floesche/LED-Display_G3_Hardware_Controller/README.md

---
title: Controller PCB
parent: Generation 3
---

# panels_controller_design  

CAD design files, gerber files and parts list for the Panels Controller.
