floesche/LED-Display_G3_Hardware_Controller/docs/assets/panel_controller_rev_c_schematic.pdf

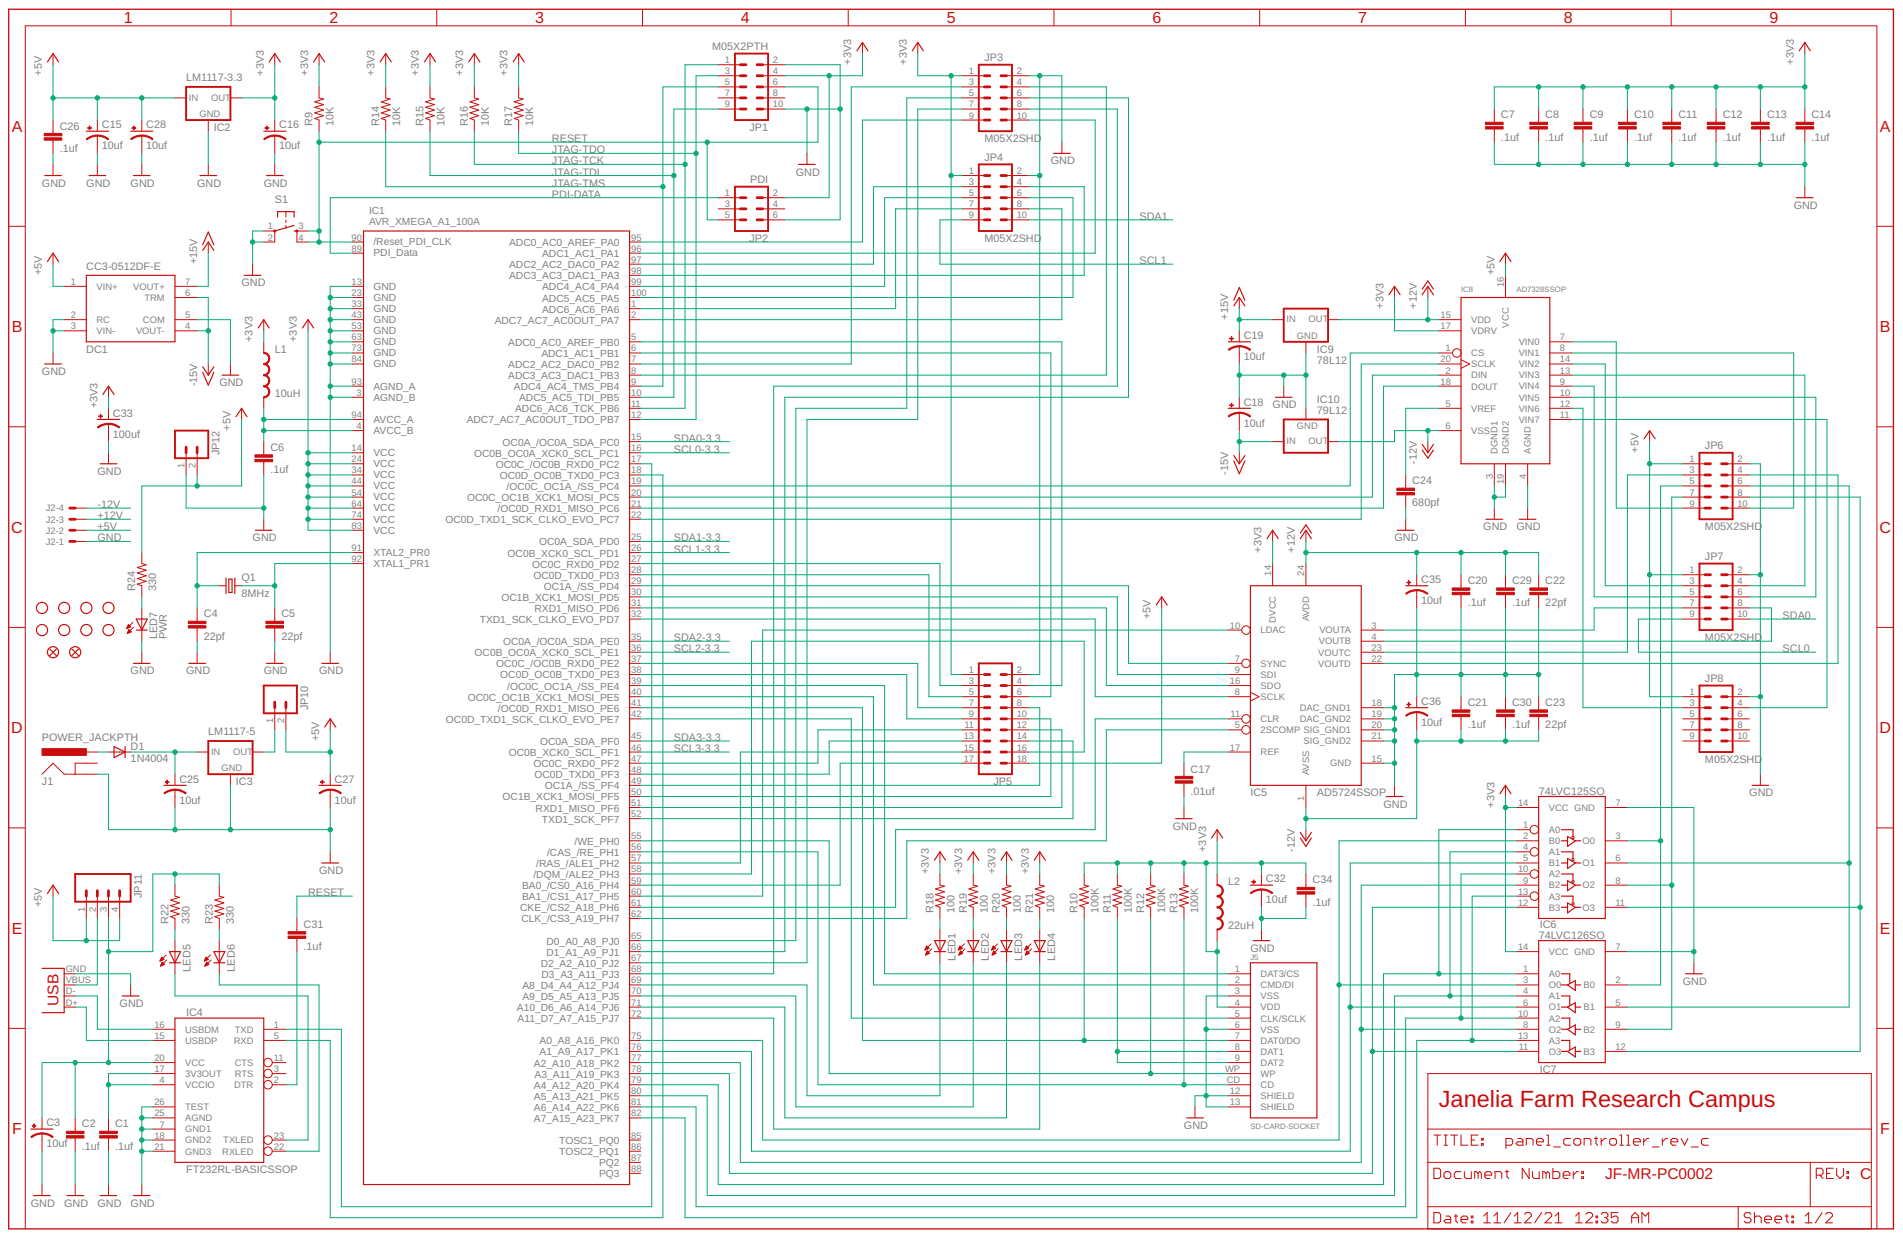
[picture p3: page 1]

RESET
JTAG-TDO
JTAG-TCK
JTAG-TDI PDI-DATA
JTAG-TMS

GND

48
49
50

Janelia Farm Research Campus

GND GND

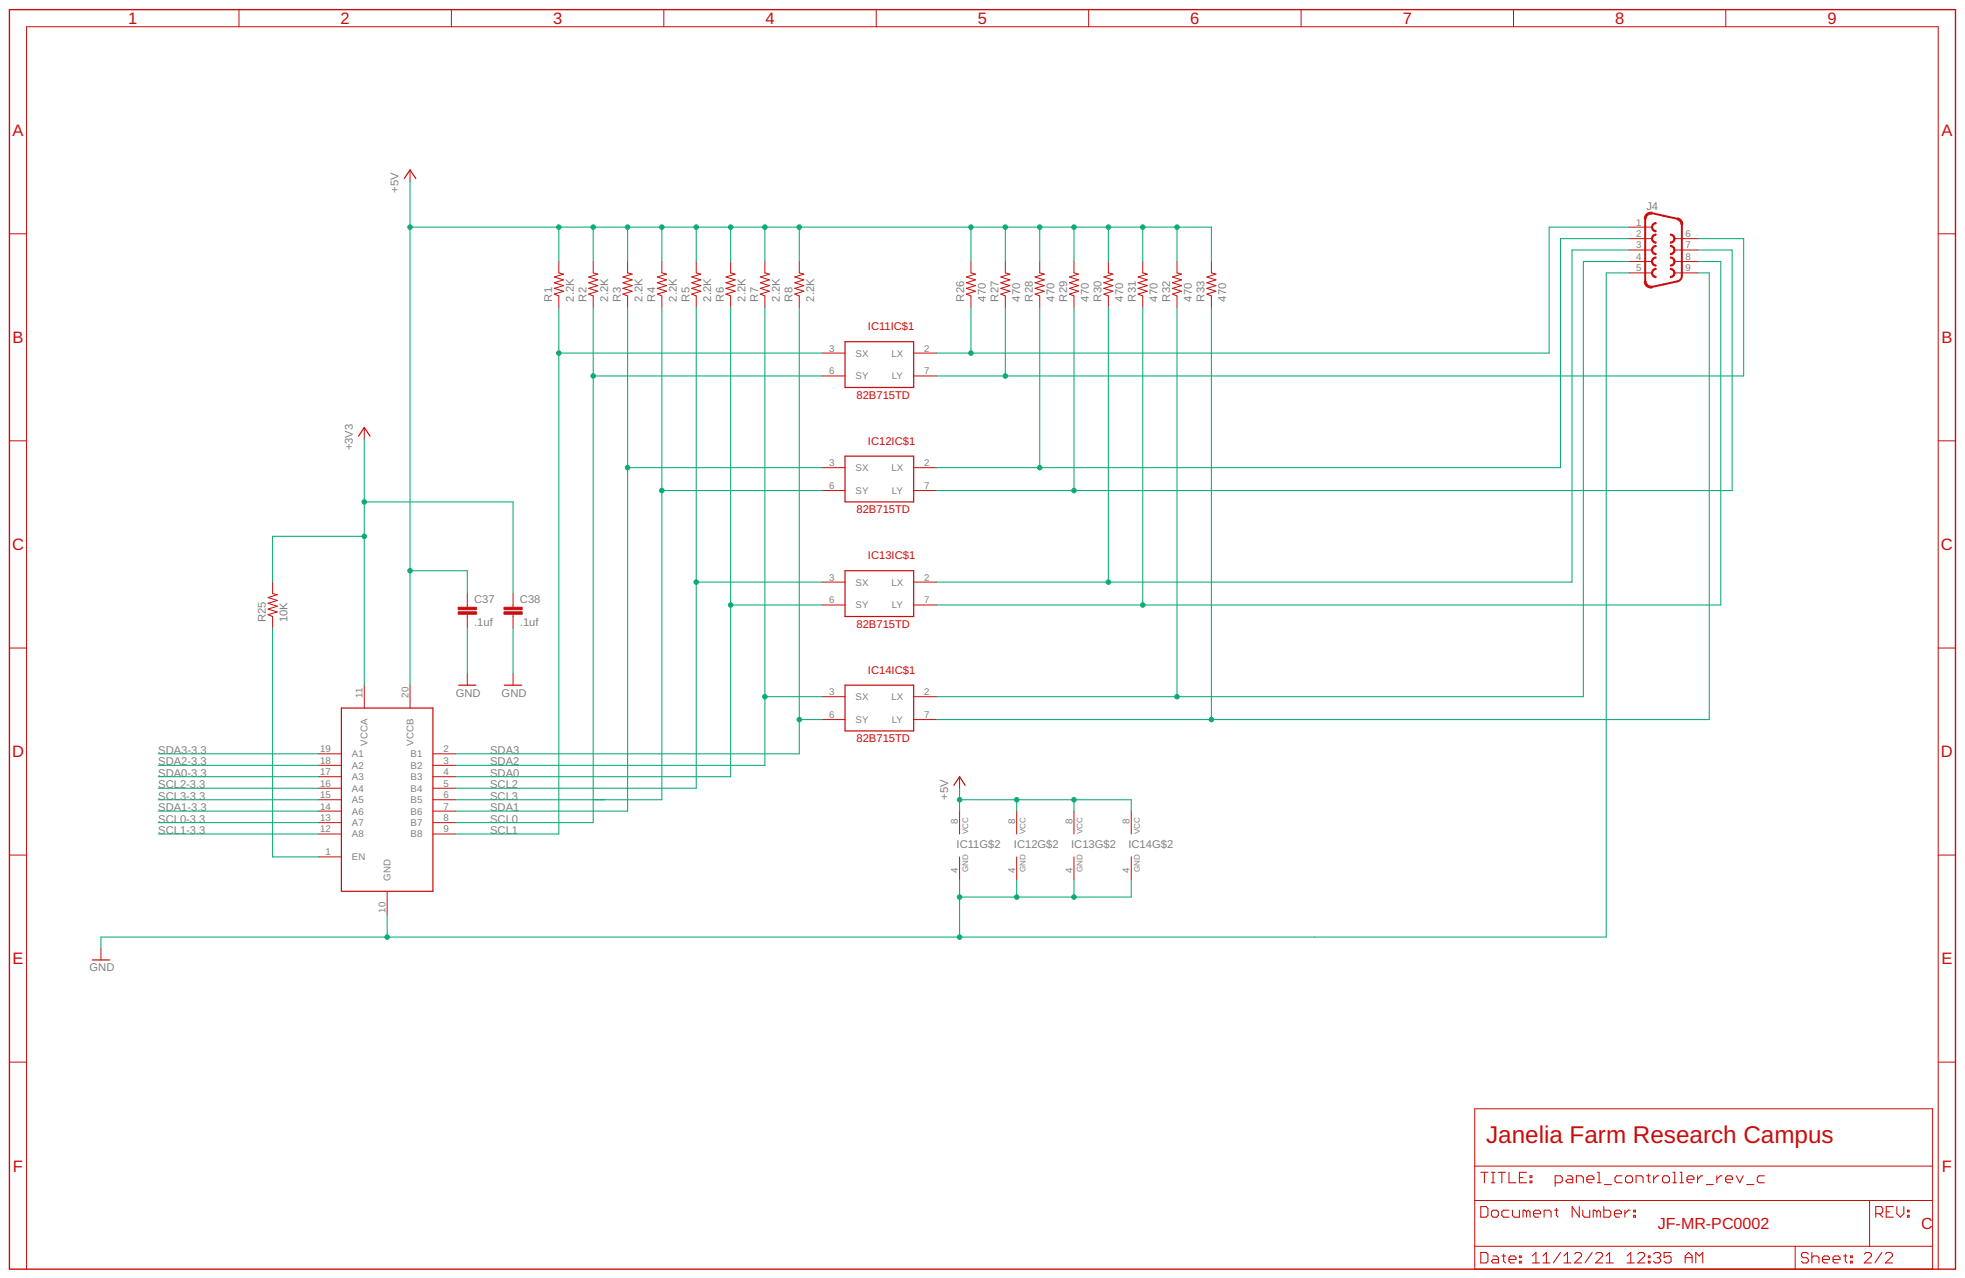
[picture p4: page 2]

3 B3
4 B4
5 B5
6 B6
7 B7

Janelia Farm Research Campus
