floesche/LED-Display_G3_Hardware_Controller/panel_controller_rev_c.brd

## EAGLE design panel_controller_rev_c.brd (2021-11-12)

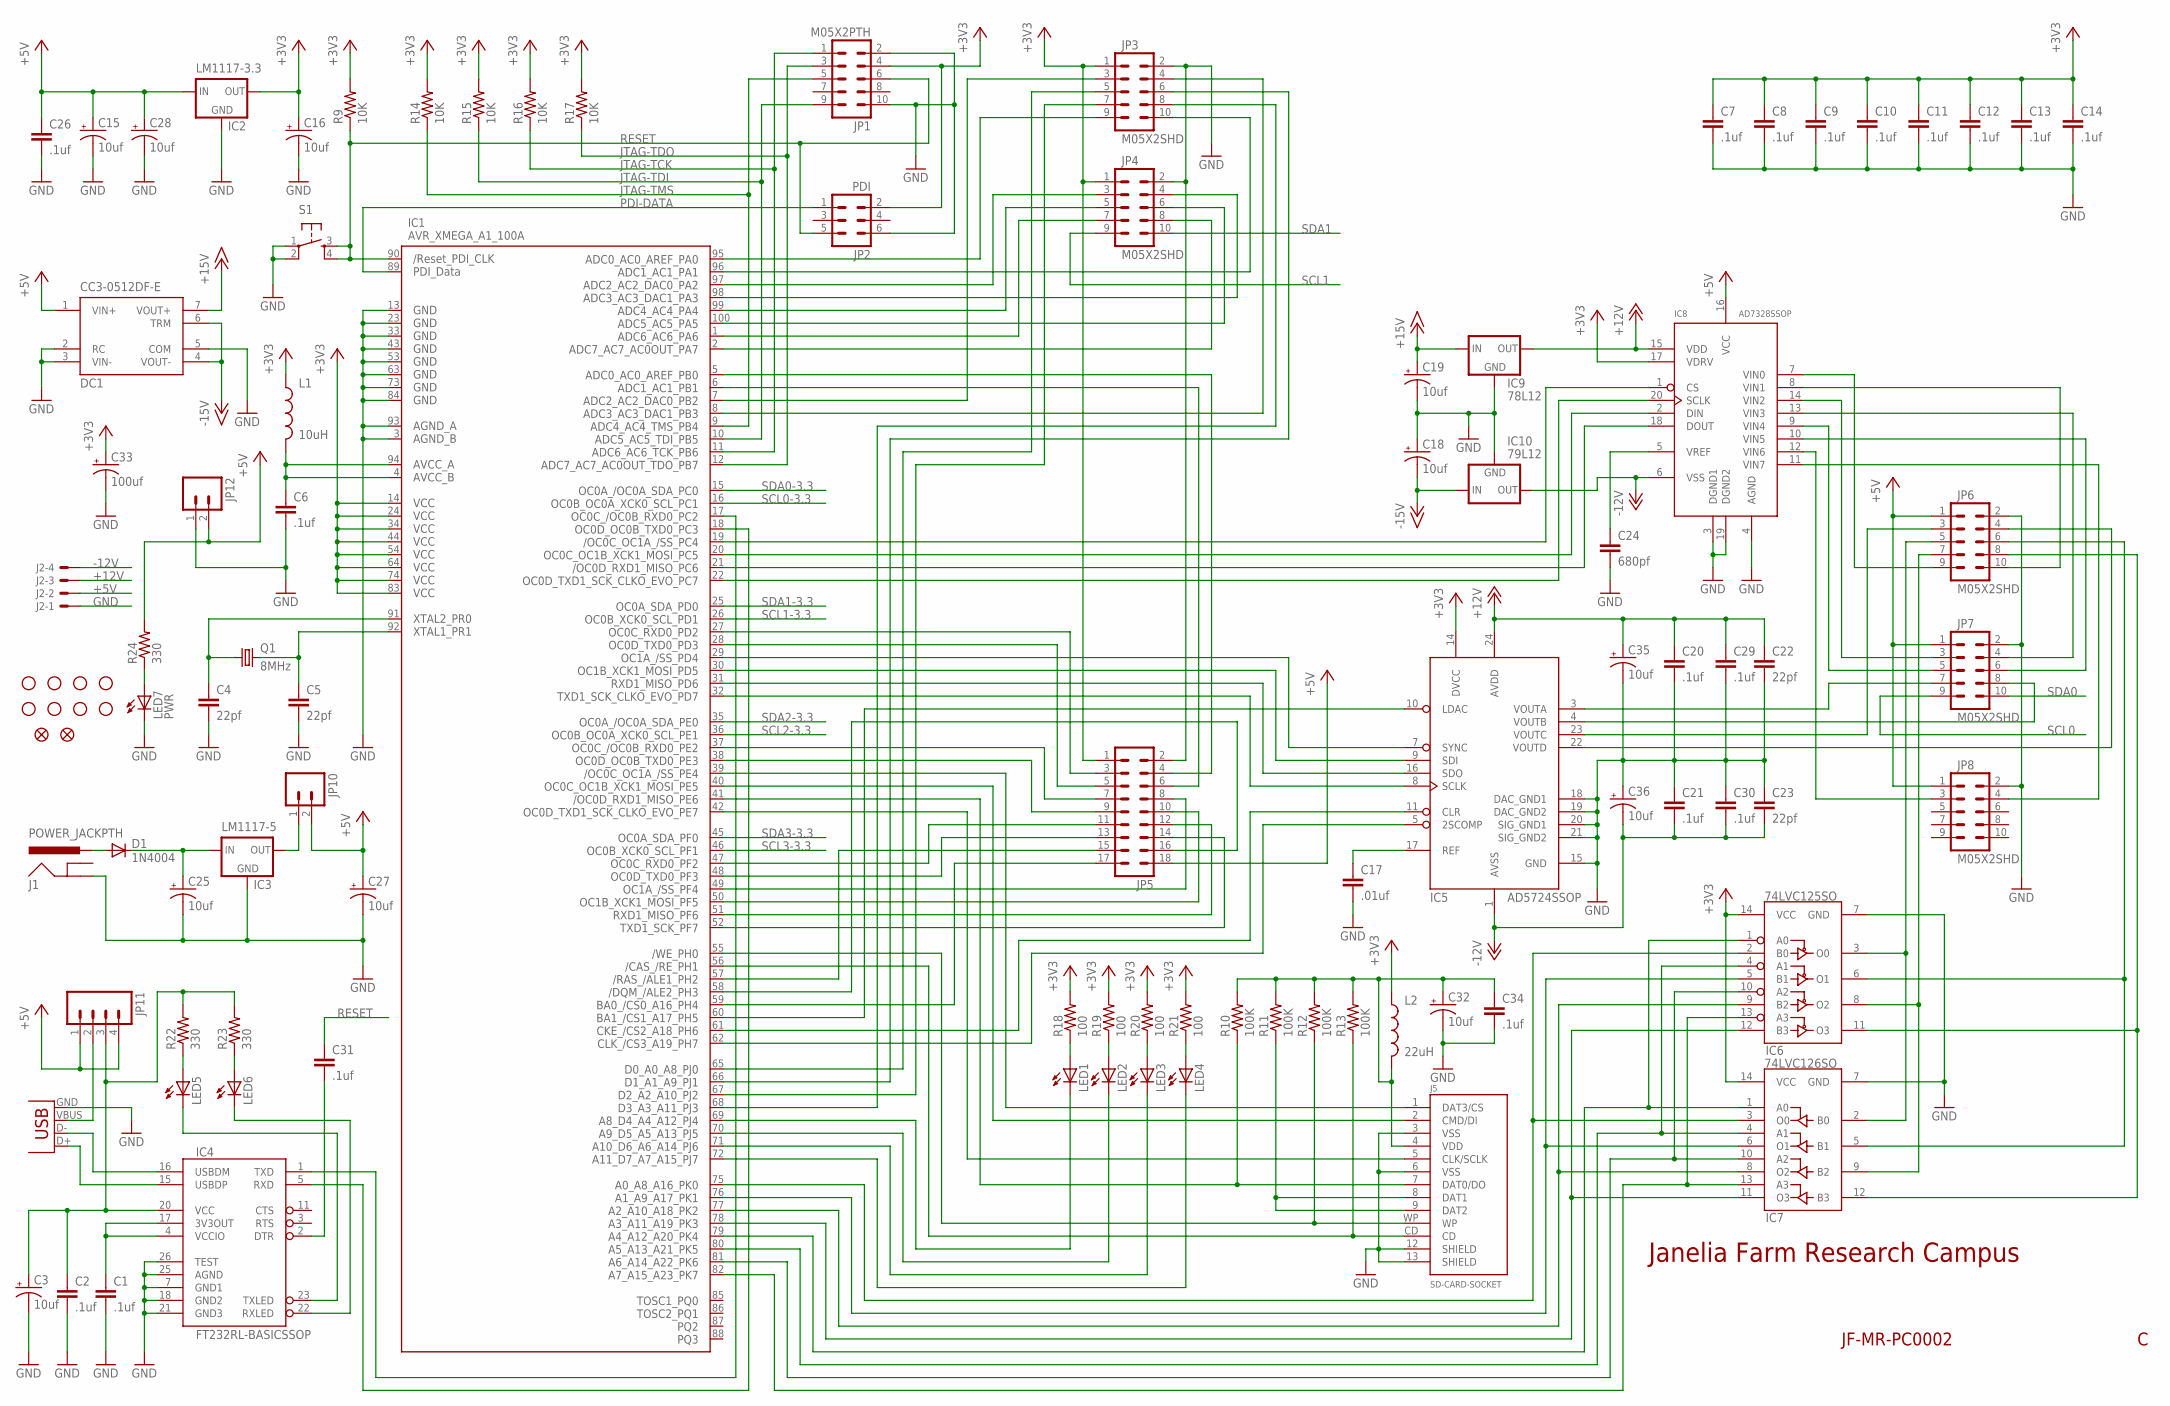
[picture p5: schematic panel_controller_rev_c.sch, sheet 1]

Parts:
C1, C2, C6, C7, C8, C9, C10, C11, C12, C13, C14, C20, C21, C26, C29, C30, C31, C34: .1uf; 0603
C3, C15, C16, C18, C19, C25, C27, C28, C32, C35, C36: 10uf; EIA3216
C4, C5, C22, C23: 22pf; 0603
C17: .01uf; 0603
C24: 680pf; 0603
C33: 100uf; PANASONIC_E
D1: 1N4004; DO41-10
DC1: CC3-0512DF-E; CC3-TH
IC1: AVR_XMEGA_A1_100A; TQFP100
IC2: LM1117-3.3; SOT223
IC3: LM1117-5; SOT223
IC4: FT232RL-BASICSSOP; SSOP28DB
IC5: AD5724SSOP; TSSOP24
IC6: 74LVC125SO; SO014
IC7: 74LVC126SO; SO014
IC8: AD7328SSOP; TSSOP20
IC9: 78L12; SOT89
IC10: 79L12; SOT89
J1: POWER_JACKPTH; POWER_JACK_PTH
J2: KK-156-4
J3: USBPTH; USB-B-PTH
J5: SD-CARD-SOCKET; SD-MMC_SOCKET-3M
JP1: M05X2PTH; MA05-2
JP2: PDI; MA03-2
JP3, JP4, JP6, JP7, JP8: M05X2SHD; 2X5-SHROUDED
JP5: MA09-2
JP10, JP12: M02PTH; 1X02
JP11: M04PTH; 1X04
L1: 10uH; 0805
L2: 22uH; 0805
LED1, LED2, LED3, LED4, LED5, LED6: LED3MM
LED7: PWR; LED3MM
Q1: 8MHz; HC49UP
R9, R14, R15, R16, R17: 10K; 0603
R10, R11, R12, R13: 100K; 0603
R18, R19, R20, R21: 100; 0603
R22, R23, R24: 330; 0603
S1: TAC_SWITCHB3S-1000; OMRON
U$1, U$2: FIDUCIAL1X2; FIDUCIAL-1X2
U$3, U$4, U$5, U$6, U$7, U$8, U$9, U$10: STAND-OFF

Connections:
+3V3: C7.1, C8.1, C9.1, C10.1, C11.1, C12.1, C13.1, C14.1, C16.A (+), C33.+, IC1.14 (VCC1), IC1.24 (VCC2), IC1.34 (VCC3), IC1.44 (VCC4), IC1.54 (VCC5), IC1.64 (VCC6), IC1.74 (VCC7), IC1.83 (VCC8), IC2.2 (OUT), IC5.14 (DVCC), IC6.14 (VCC), IC7.14 (VCC), IC8.17 (VDRV), JP1.4, JP2.2, JP3.1, JP4.1, JP5.1, L1.1, L2.1, R9.2, R14.2, R15.2, R16.2, R17.2, R18.2, R19.2, R20.2, R21.2; also elsewhere on the board
+5V: C15.A (+), C26.1, C27.A (+), C28.A (+), DC1.1 (VIN+), IC2.3 (IN), IC8.16 (VCC), J2.2, JP5.18, JP6.1, JP7.1, JP8.1, JP10.2, JP11.1, JP11.4, JP12.2, R24.2; also elsewhere on the board
+12V: C20.1, C22.1, C29.1, C35.A (+), IC5.24 (AVDD), IC8.15 (VDD), IC9.1 (OUT), J2.3
+15V: C19.A (+), DC1.7 (VOUT+), IC9.3 (IN)
-12V: C21.2, C23.2, C30.2, C36.C (-), IC5.1 (AVSS), IC8.6 (VSS), IC10.3 (OUT), J2.4
-15V: C18.C (-), DC1.4 (VOUT-), DC1.6 (TRM), IC10.2 (IN)
GND: C1.2, C2.2, C3.C (-), C4.2, C5.2, C6.2, C7.2, C8.2, C9.2, C10.2, C11.2, C12.2, C13.2, C14.2, C15.C (-), C16.C (-), C17.2, C18.A (+), C19.C (-), C20.2, C21.1, C22.2, C23.1, C24.2, C25.C (-), C26.2, C27.C (-), C28.C (-), C29.2, C30.1, C32.C (-), C33.-, C34.2, C35.C (-), C36.A (+), DC1.2 (RC), DC1.3 (VIN-), DC1.5 (COM), IC1.3 (AGND_B), IC1.13 (GND1), IC1.23 (GND2), IC1.33 (GND3), IC1.43 (GND4), IC1.53 (GND5), IC1.63 (GND6), IC1.73 (GND7), IC1.84 (GND8), IC1.93 (AGND_A), IC2.1 (GND), IC3.1 (GND), IC4.7 (GND1), IC4.18 (GND2), IC4.21 (GND3), IC4.25 (AGND), IC4.26 (TEST), IC5.15 (GND), IC5.18 (DAC_GND1), IC5.19 (DAC_GND2), IC5.20 (SIG_GND1), IC5.21 (SIG_GND2), IC6.7 (GND), IC7.7 (GND), IC8.3 (DGND1), IC8.4 (AGND), IC8.19 (DGND2), IC9.2 (GND), IC10.1 (GND), J1.GND, J2.1, J3.GND, J5.3 (VSS), J5.6 (VSS), J5.12 (SHIELD), J5.13 (SHIELD), JP1.2, JP1.10, JP2.6, JP3.2, JP4.2, JP5.2, JP6.2, JP7.2, JP8.2, JP12.1, LED7.K (C), S1.1, S1.2; also elsewhere on the board
JTAG-TCK: IC1.11 (PB6), JP1.1, R16.1
JTAG-TDI: IC1.10 (PB5), JP1.9, R15.1
JTAG-TDO: IC1.12 (PB7), JP1.3, R17.1
JTAG-TMS: IC1.9 (PB4), JP1.5, R14.1
unnamed: IC4.16 (USBDM), J3.D-
unnamed: IC4.15 (USBDP), J3.D+
unnamed: J3.VBUS, JP11.2
unnamed: C1.1, IC4.4 (VCCIO), IC4.17 (3V3OUT)
unnamed: IC1.18 (PC3), IC4.5 (RXD)
unnamed: IC1.19 (PC4), IC8.1 (CS)
unnamed: IC1.57 (PH2), JP5.15
unnamed: IC1.65 (PJ0), JP3.5
unnamed: IC1.67 (PJ2), JP3.7
unnamed: IC1.17 (PC2), IC4.1 (TXD)
unnamed: LED5.A, R22.1
unnamed: IC1.40 (PE5), J5.2 (CMD/DI)
unnamed: IC1.41 (PE6), J5.7 (DAT0/DO), R10.1
unnamed: IC1.42 (PE7), J5.5 (CLK/SCLK)
unnamed: IC1.39 (PE4), J5.1 (DAT3/CS)
unnamed: IC1.69 (PJ4), LED1.K (C)
unnamed: IC1.70 (PJ5), LED2.K (C)
unnamed: C4.1, IC1.91 (PR0), Q1.1
unnamed: C5.1, IC1.92 (PR1), Q1.2
unnamed: IC1.71 (PJ6), LED3.K (C)
unnamed: IC1.72 (PJ7), LED4.K (C)
unnamed: LED1.A, R18.1
unnamed: C6.1, IC1.4 (AVCC_B), IC1.94 (AVCC_A), L1.2
unnamed: LED2.A, R19.1
unnamed: LED3.A, R20.1
unnamed: LED4.A, R21.1
unnamed: IC1.66 (PJ1), JP3.6
unnamed: IC1.68 (PJ3), JP3.8
unnamed: IC1.2 (PA7), JP4.8
unnamed: IC1.1 (PA6), JP4.7
unnamed: IC1.100 (PA5), JP4.6
unnamed: J5.8 (DAT1), J5.9 (DAT2), R11.1
unnamed: IC1.55 (PH0), J5.WP, R12.1
unnamed: IC1.56 (PH1), J5.CD, R13.1
unnamed: IC1.99 (PA4), JP4.5
unnamed: IC1.98 (PA3), JP4.4
unnamed: IC1.97 (PA2), JP4.3
unnamed: IC1.96 (PA1), JP3.10
unnamed: IC1.95 (PA0), JP3.9
unnamed: IC1.7 (PB2), JP3.3
unnamed: IC1.8 (PB3), JP3.4
unnamed: IC1.20 (PC5), IC8.2 (DIN)
unnamed: IC1.22 (PC7), IC8.20 (SCLK)
unnamed: IC1.21 (PC6), IC8.18 (DOUT)
unnamed: IC1.32 (PD7), IC5.8 (SCLK)
unnamed: LED6.A, R23.1
unnamed: C24.1, IC8.5 (VREF)
unnamed: IC1.31 (PD6), IC5.16 (SDO)
unnamed: IC1.30 (PD5), IC5.9 (SDI)
unnamed: IC1.29 (PD4), IC5.7 (SYNC)
unnamed: IC1.61 (PH6), IC5.11 (CLR)
unnamed: C17.1, IC5.17 (REF)
unnamed: IC1.37 (PE2), JP5.7
unnamed: IC1.38 (PE3), JP5.9
unnamed: IC1.27 (PD2), JP5.3
unnamed: IC1.28 (PD3), JP5.5
unnamed: IC1.5 (PB0), JP5.4
unnamed: IC1.6 (PB1), JP5.6
unnamed: IC1.47 (PF2), JP5.11
unnamed: IC1.48 (PF3), JP5.13
unnamed: IC1.49 (PF4), JP5.8
unnamed: IC1.50 (PF5), JP5.10
unnamed: IC1.51 (PF6), JP5.12
unnamed: IC1.52 (PF7), JP5.14
unnamed: IC1.62 (PH7), IC5.5 (2SCOMP)
unnamed: IC1.75 (PK0), IC6.2 (B0), IC7.3 (O0)
unnamed: IC1.76 (PK1), IC6.5 (B1), IC7.6 (O1)
unnamed: IC1.77 (PK2), IC6.9 (B2), IC7.8 (O2)
unnamed: IC1.78 (PK3), IC6.12 (B3), IC7.11 (O3)
unnamed: IC1.79 (PK4), IC6.1 (A0), IC7.1 (A0)
unnamed: C2.1, C3.A (+), IC4.20 (VCC), JP11.3, R22.2, R23.2
unnamed: IC4.22 (RXLED), LED6.K (C)
unnamed: IC1.60 (PH5), IC5.10 (LDAC)
unnamed: IC8.11 (VIN7), JP8.4
unnamed: IC8.7 (VIN0), JP6.9
unnamed: IC8.8 (VIN1), JP6.10
unnamed: IC8.14 (VIN2), JP7.3
unnamed: IC8.13 (VIN3), JP7.4
unnamed: IC8.9 (VIN4), JP7.5
unnamed: IC8.10 (VIN5), JP7.6
unnamed: IC5.23 (VOUTC), JP6.3
unnamed: IC8.12 (VIN6), JP8.3
unnamed: IC5.3 (VOUTA), JP7.7
unnamed: IC5.4 (VOUTB), JP7.8
unnamed: IC5.22 (VOUTD), JP6.4
unnamed: C32.A (+), C34.1, J5.4 (VDD), L2.2, R10.2, R11.2, R12.2, R13.2
unnamed: IC1.80 (PK5), IC6.4 (A1), IC7.4 (A1)
unnamed: IC1.81 (PK6), IC6.10 (A2), IC7.10 (A2)
unnamed: IC1.82 (PK7), IC6.13 (A3), IC7.13 (A3)
unnamed: IC4.23 (TXLED), LED5.K (C)
unnamed: IC6.3 (O0), IC7.2 (B0), JP6.5
unnamed: IC6.6 (O1), IC7.5 (B1), JP6.6
unnamed: IC6.8 (O2), IC7.9 (B2), JP6.7
unnamed: IC6.11 (O3), IC7.12 (B3), JP6.8
unnamed: IC1.59 (PH4), JP5.17
unnamed: IC1.58 (PH3), JP5.16
unnamed: LED7.A, R24.1
unnamed: C31.2, IC4.2 (DTR)
unnamed: D1.A, J1.PWR
unnamed: C25.A (+), D1.C, IC3.3 (IN)
unnamed: IC3.2 (OUT), JP10.1
PDI-DATA: IC1.89 (PDI_DATA), JP2.1
RESET: C31.1, IC1.90 (RESET), JP1.6, JP2.5, R9.1, S1.3, S1.4
SCL0: JP7.9; also elsewhere on the board
SCL0-3.3: IC1.16 (PC1); also elsewhere on the board
SCL1: JP4.9; also elsewhere on the board
SCL1-3.3: IC1.26 (PD1); also elsewhere on the board
SCL2-3.3: IC1.36 (PE1); also elsewhere on the board
SCL3-3.3: IC1.46 (PF1); also elsewhere on the board
SDA0: JP7.10; also elsewhere on the board
SDA0-3.3: IC1.15 (PC0); also elsewhere on the board
SDA1: JP4.10; also elsewhere on the board
SDA1-3.3: IC1.25 (PD0); also elsewhere on the board
SDA2-3.3: IC1.35 (PE0); also elsewhere on the board
SDA3-3.3: IC1.45 (PF0); also elsewhere on the board

Notes on the sheet:
Janelia Farm Research Campus
JF-MR-PC0002

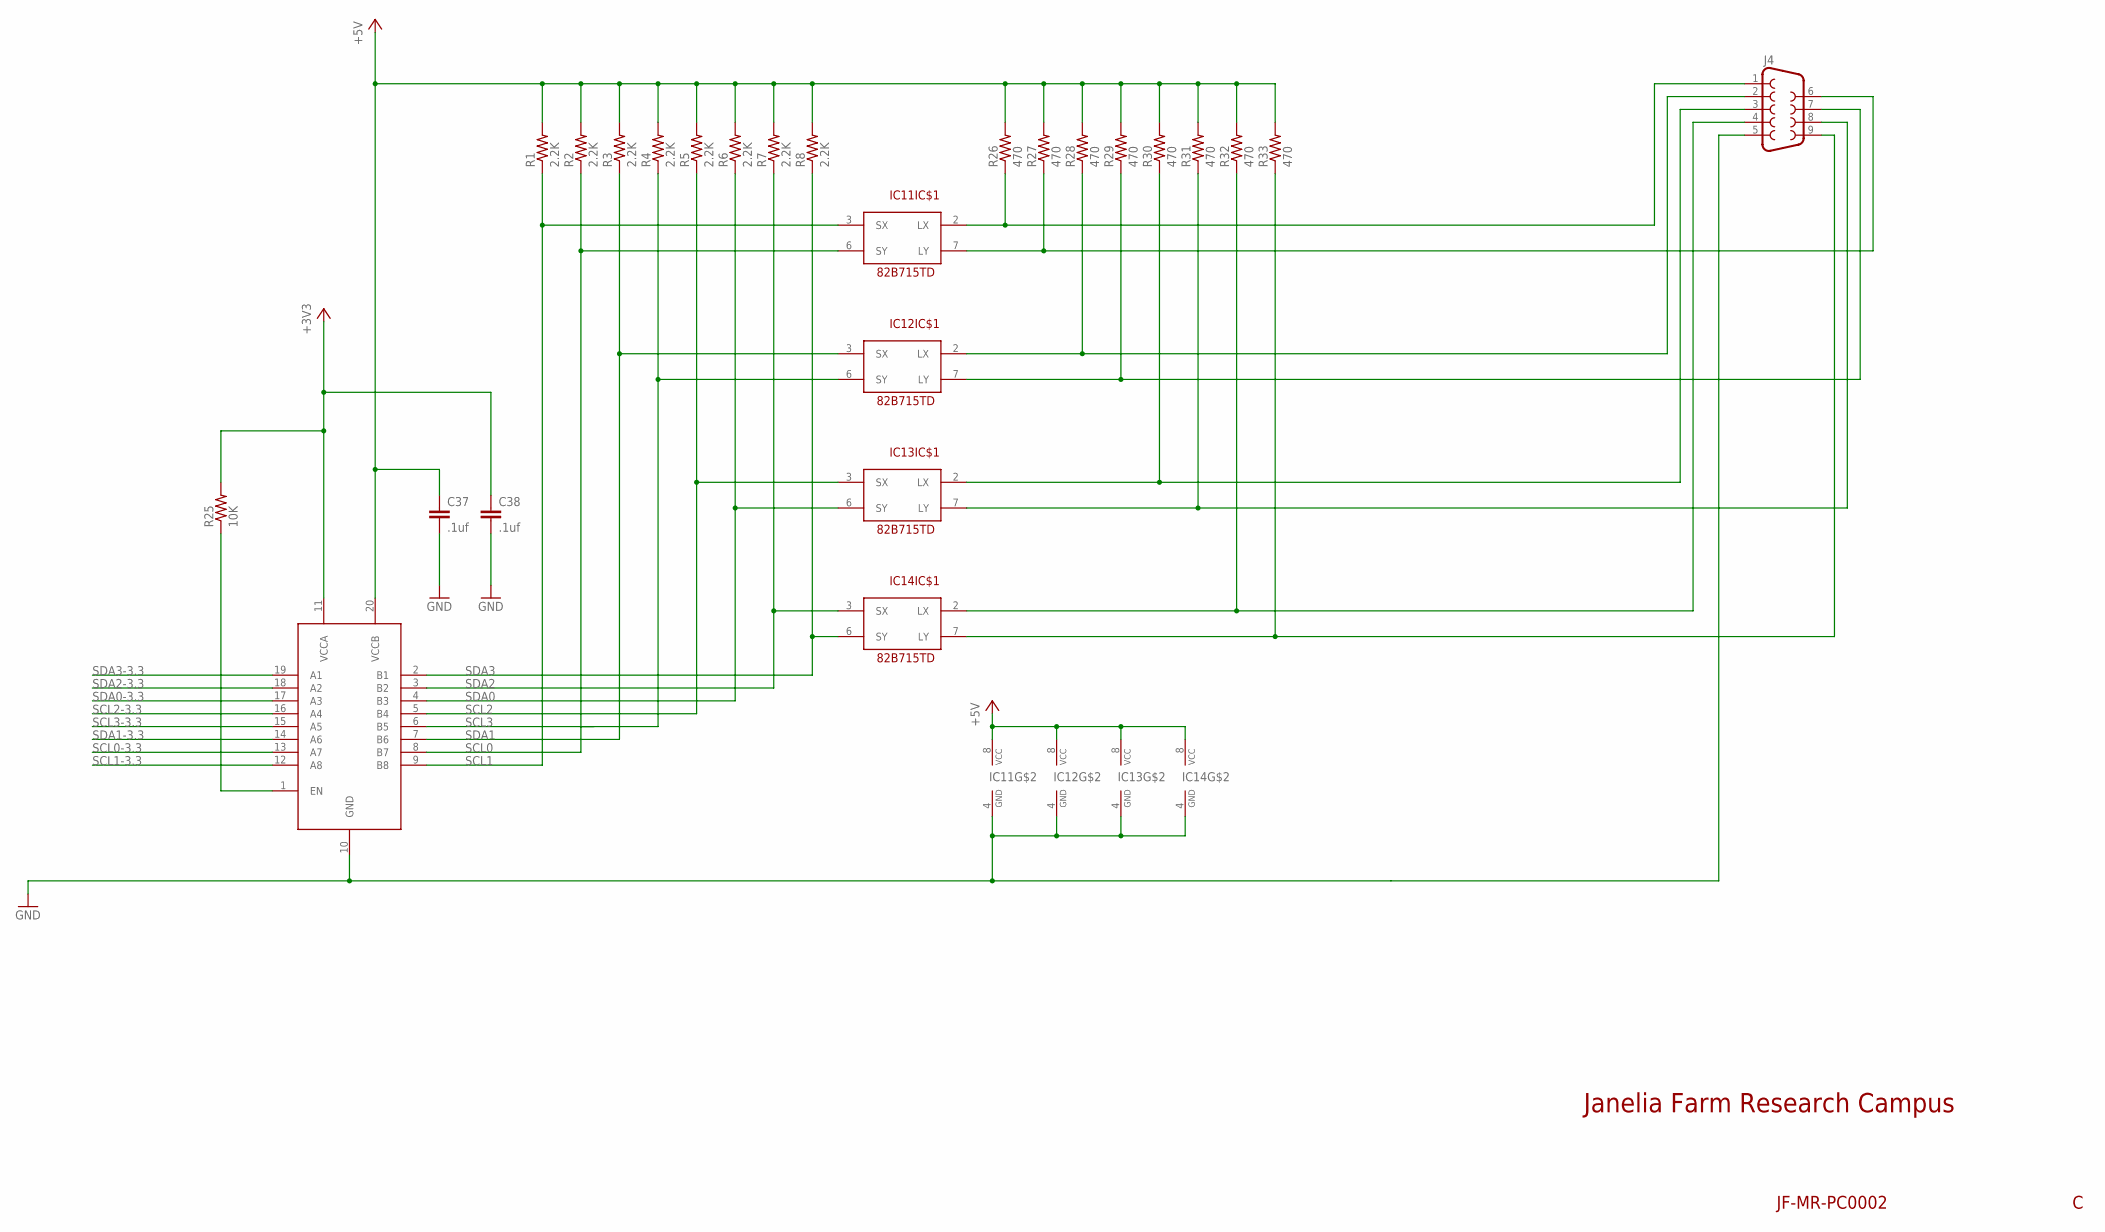
[picture p6: schematic panel_controller_rev_c.sch, sheet 2]

Parts:
C37, C38: .1uf; 0603
IC11, IC12, IC13, IC14: 82B715TD; SO08
IC15: PCA9519; TSSOP20
J4: DB9
R1, R2, R3, R4, R5, R6, R7, R8: 2.2K; 0603
R25: 10K; 0603
R26, R27, R28, R29, R30, R31, R32, R33: 470; 0603

Connections:
+3V3: C38.1, IC15.11 (VCCA), R25.2; also elsewhere on the board
+5V: C37.1, IC11.8 (VCC), IC12.8 (VCC), IC13.8 (VCC), IC14.8 (VCC), IC15.20 (VCCB), R1.2, R2.2, R3.2, R4.2, R5.2, R6.2, R7.2, R8.2, R26.2, R27.2, R28.2, R29.2, R30.2, R31.2, R32.2, R33.2; also elsewhere on the board
GND: C37.2, C38.2, IC11.4 (GND), IC12.4 (GND), IC13.4 (GND), IC14.4 (GND), IC15.10 (GND), J4.5; also elsewhere on the board
unnamed: IC12.2 (LX), J4.2, R28.1
unnamed: IC12.7 (LY), J4.7, R29.1
unnamed: IC13.2 (LX), J4.3, R30.1
unnamed: IC14.2 (LX), J4.4, R32.1
unnamed: IC14.7 (LY), J4.9, R33.1
unnamed: IC13.7 (LY), J4.8, R31.1
unnamed: IC11.7 (LY), J4.6, R27.1
unnamed: IC11.2 (LX), J4.1, R26.1
unnamed: IC15.1 (EN), R25.1
SCL0: IC11.6 (SY), IC15.8 (B7), R2.1; also elsewhere on the board
SCL0-3.3: IC15.13 (A7); also elsewhere on the board
SCL1: IC11.3 (SX), IC15.9 (B8), R1.1; also elsewhere on the board
SCL1-3.3: IC15.12 (A8); also elsewhere on the board
SCL2: IC13.3 (SX), IC15.5 (B4), R5.1
SCL2-3.3: IC15.16 (A4); also elsewhere on the board
SCL3: IC12.6 (SY), IC15.6 (B5), R4.1
SCL3-3.3: IC15.15 (A5); also elsewhere on the board
SDA0: IC13.6 (SY), IC15.4 (B3), R6.1; also elsewhere on the board
SDA0-3.3: IC15.17 (A3); also elsewhere on the board
SDA1: IC12.3 (SX), IC15.7 (B6), R3.1; also elsewhere on the board
SDA1-3.3: IC15.14 (A6); also elsewhere on the board
SDA2: IC14.3 (SX), IC15.3 (B2), R7.1
SDA2-3.3: IC15.18 (A2); also elsewhere on the board
SDA3: IC14.6 (SY), IC15.2 (B1), R8.1
SDA3-3.3: IC15.19 (A1); also elsewhere on the board

Notes on the sheet:
Janelia Farm Research Campus
JF-MR-PC0002

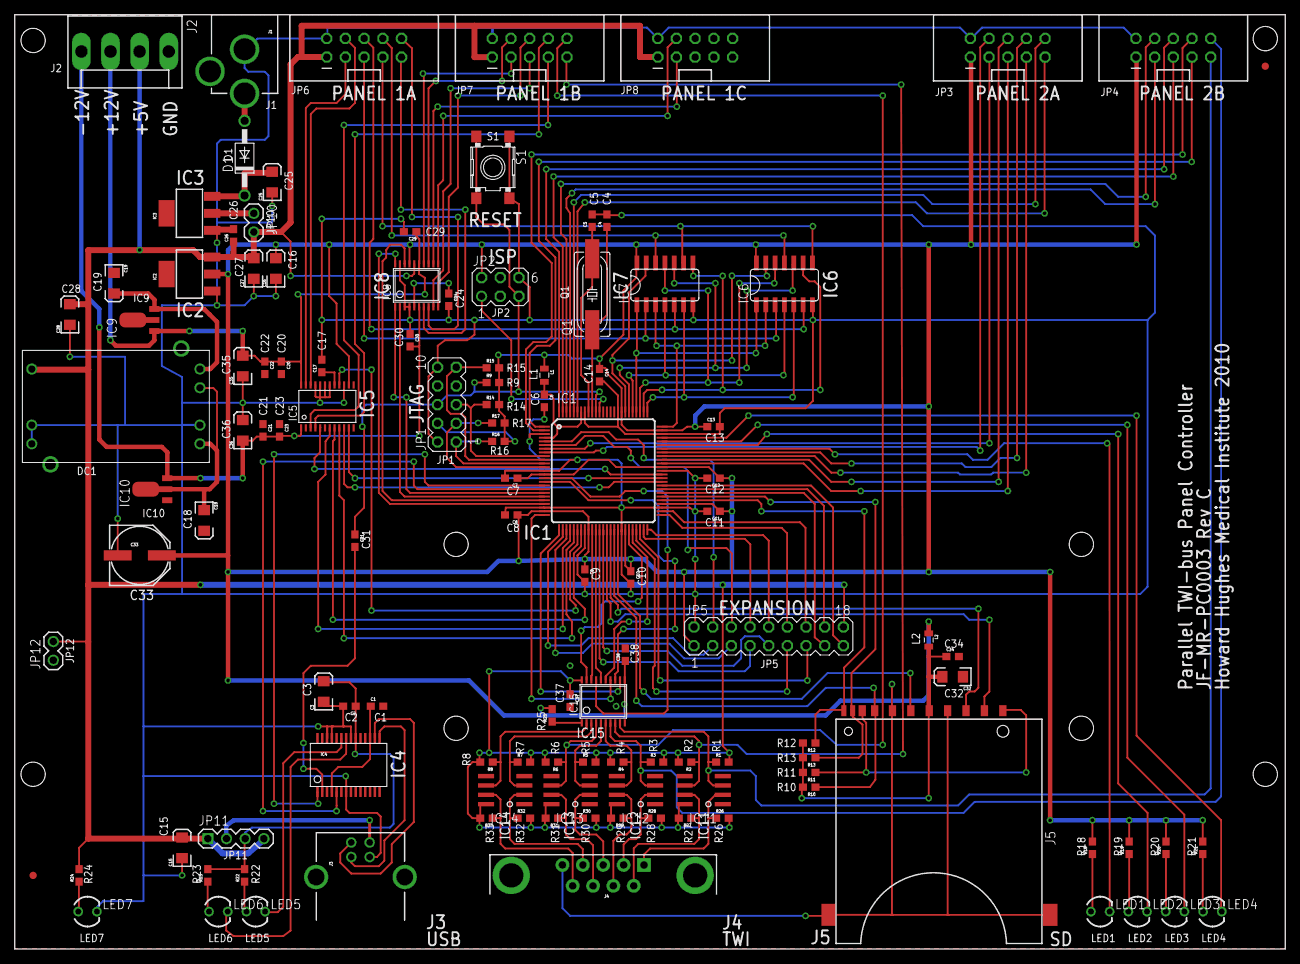
[picture p7: board panel_controller_rev_c.brd from above]

Board: 2 copper layers, 172.7 x 127.0 mm, 125 parts (0 on the bottom side), 139 nets.
