floesche/LED-Display_G3_Hardware_Controller/(commit log)

2018-11-13 Project creation.
    [panel_controller_rev_c.brd, panel_controller_rev_c.sch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]
2021-07-08 add schematic as PDF
2021-11-12 clean up controller
    [panel_controller_rev_c.brd, panel_controller_rev_c.sch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]
